schn27/Servo/doc/servo.png

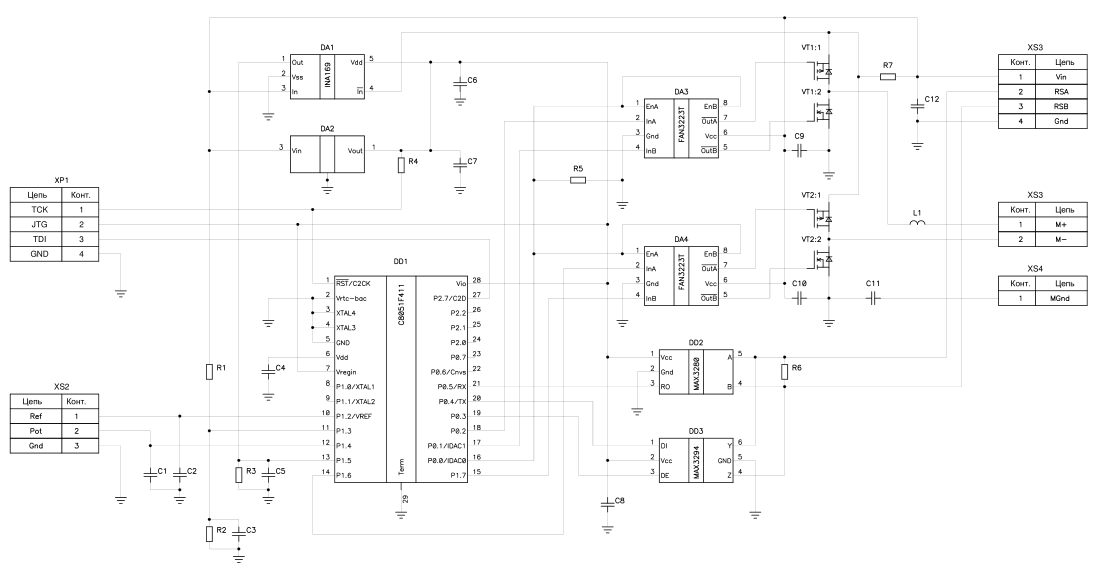
doc/servo.png
