schn27/Servo/doc/servo.xls

Title:
Author:
Count | RefDes | Value | Part Number | Description | Manufacturer
1 | C1 | 10n | 06035C103JAT2A | CAP CER 10000PF 50V X7R 5% 0603 | AVX Corporation
1 | C2 | 0.1u | 06035C104KAT2A | CAP CER .10UF 50V X7R 10% 0603 | AVX Corporation
1 | C3 | 10n | 06035C103JAT2A | CAP CER 10000PF 50V X7R 5% 0603 | AVX Corporation
1 | C4 | 4.7u | 0805YC475KAT2A | CAP CER 4.7UF 16V X7R 10% 0805 | AVX Corporation
1 | C5 | 10n | 06035C103JAT2A | CAP CER 10000PF 50V X7R 5% 0603 | AVX Corporation
1 | C6 | 0.1u | 06035C104KAT2A | CAP CER .10UF 50V X7R 10% 0603 | AVX Corporation
1 | C7 | 4.7u | 0805YC475KAT2A | CAP CER 4.7UF 16V X7R 10% 0805 | AVX Corporation
3 | C8 | 0.1u | 06035C104KAT2A | CAP CER .10UF 50V X7R 10% 0603 | AVX Corporation
 | C9 | 0.1u | 06035C104KAT2A | CAP CER .10UF 50V X7R 10% 0603 | AVX Corporation
 | C10 | 0.1u | 06035C104KAT2A | CAP CER .10UF 50V X7R 10% 0603 | AVX Corporation
1 | C11 | 22n | 0805PC223KAT1A | CAP CERM 22000PF 250V X7R 0805 | AVX Corporation
1 | C12 | 10u | GRM32DR71E106KA | CAP CER 10UF 25V 10% X7R 1210 | Murata Electronics North America
1 | DA1 |  | INA169NA/250PBF | IC CURRENT MONITOR 0.5% SOT23-5 | Texas Instruments
1 | DA2 |  | MCP1804T-3302I/MB | IC REG LDO 3.3V 150MA SOT89-3 | Microchip Technology
2 | DA3 |  | FAN3223TMPX | IC GATE DVR LOW DUAL 4A HS 8MLP | Fairchild Semiconductor
 | DA4 |  | FAN3223TMPX | IC GATE DVR LOW DUAL 4A HS 8MLP | Fairchild Semiconductor
1 | DD1 |  | C8051F411-GM | IC 8051 MCU 32K FLASH 28QFN | Silicon Laboratories Inc
1 | DD2 |  | MAX3280EAUK+T | IC RX RS485/422 SOT23-5 | Maxim Integrated Products
1 | DD3 |  | MAX3294AUT+T | IC TX RS485/422 2.5MBPS SOT23-6 | Maxim Integrated Products
1 | L1 | 22uH | 7447798221 | INDUCTOR POWER 22UH 4.1A SMD | Wurth Electronics Inc
1 | R1 | 10k | ERJ3EKF1002V | RES 10.0K OHM 1/10W 1% 0603 SMD | Panasonic - ECG
1 | R2 | 1k | ERJ3EKF1001V | RES 1.00K OHM 1/10W 1% 0603 SMD | Panasonic - ECG
1 | R3 | 10k | ERJ3EKF1002V | RES 10.0K OHM 1/10W 1% 0603 SMD | Panasonic - ECG
3 | R4 | 1k | ERJ3EKF1001V | RES 1.00K OHM 1/10W 1% 0603 SMD | Panasonic - ECG
 | R5 | 1k | ERJ3EKF1001V | RES 1.00K OHM 1/10W 1% 0603 SMD | Panasonic - ECG
 | R6 | 1k | ERJ3EKF1001V | RES 1.00K OHM 1/10W 1% 0603 SMD | Panasonic - ECG
1 | R7 | 0.056 | RL1220T-R056-G | RES .056 OHM 1/4W 2% 0805 SMD | Susumu Co Ltd
2 | VT1 |  | FDS8858CZ | MOSFET DUAL N/P-CHAN 30V SO-8 | Fairchild Semiconductor
 | VT2 |  | FDS8858CZ | MOSFET DUAL N/P-CHAN 30V SO-8 | Fairchild Semiconductor
1 | XP1 | JTG | M22-5320405 | 2.00mm Pitch DIL Vertical Pin Header SMT | Harwin Plc.
Внешний разъем
1 | XP1 |  | S10L0C-P04PFG0-200S | male crimp, 04 Contacts | ODU Steckverbindungssysteme GmbH & Co. KG
1 | XS1 |  | K10L0C-P04NFG0-200S | male crimp, 04 Contacts | ODU Steckverbindungssysteme GmbH & Co. KG
