schn27/Servo/src/F410_FlashPrimitives.c

//-----------------------------------------------------------------------------
// F410_FlashPrimitives.c
//-----------------------------------------------------------------------------
// Copyright 2006 Silicon Laboratories, Inc.
// http://www.silabs.com
//
// Program Description:
//
// This program contains several useful utilities for writing and updating
// FLASH memory.
//
// FID:            41X000050
// Target:         C8051F410/1/2/3
// Tool chain:     Keil C51 8.00
// Command Line:   None
//
//
// Release 1.0
//    -Initial Revision (GP)
//    -29 SEP 2006
//

//-----------------------------------------------------------------------------
// Includes
//-----------------------------------------------------------------------------

#include <c8051F410.h>
#include "F410_FlashPrimitives.h"

//-----------------------------------------------------------------------------
// Function Prototypes
//-----------------------------------------------------------------------------

void          flash_byteWrite (FLADDR addr, char byte);
unsigned char flash_byteRead  (FLADDR addr);
void          flash_pageErase (FLADDR addr);

//-----------------------------------------------------------------------------
// FLASH_ByteWrite
//-----------------------------------------------------------------------------
//
// Return Value : None
// Parameters   :
//   1) FLADDR addr - address of the byte to write to
//                    valid range is from 0x0000 to 0x7DFE for 32K devices
//                    valid range is from 0x0000 to 0x3FFE for 16K devices
//   2) char byte - byte to write to Flash.
//
// This routine writes <byte> to the linear FLASH address <addr>.
//-----------------------------------------------------------------------------

void flash_byteWrite (FLADDR addr, char byte) {
   bit EA_SAVE = EA;                   // Preserve EA
   char xdata * data pwrite;           // FLASH write pointer

   EA = 0;                             // Disable interrupts

   VDM0CN = 0xA0;                      // Enable VDD monitor and high threshold

   RSTSRC = 0x02;                      // Enable VDD monitor as a reset source

   pwrite = (char xdata *) addr;

   FLKEY  = 0xA5;                      // Key Sequence 1
   FLKEY  = 0xF1;                      // Key Sequence 2
   PSCTL |= 0x01;                      // PSWE = 1 which enables writes

   VDM0CN = 0xA0;                      // Enable VDD monitor and high threshold

   RSTSRC = 0x02;                      // Enable VDD monitor as a reset source

   *pwrite = byte;                     // Write the byte

   PSCTL &= ~0x01;                     // PSWE = 0 which disable writes

   EA = EA_SAVE;                       // Restore interrupts
}

//-----------------------------------------------------------------------------
// FLASH_ByteRead
//-----------------------------------------------------------------------------
//
// Return Value :
//      unsigned char - byte read from Flash
// Parameters   :
//   1) FLADDR addr - address of the byte to read to
//                    valid range is from 0x0000 to 0x7DFE for 32K devices
//                    valid range is from 0x0000 to 0x3FFE for 16K devices
//
// This routine reads a <byte> from the linear FLASH address <addr>.
//-----------------------------------------------------------------------------

unsigned char flash_byteRead (FLADDR addr) {
   bit EA_SAVE = EA;                   // Preserve EA
   char code * data pread;             // FLASH read pointer
   unsigned char byte;

   EA = 0;                             // Disable interrupts

   pread = (char code *) addr;

   byte = *pread;                      // Read the byte

   EA = EA_SAVE;                       // Restore interrupts

   return byte;
}

//-----------------------------------------------------------------------------
// FLASH_PageErase
//-----------------------------------------------------------------------------
//
// Return Value : None
// Parameters   :
//   1) FLADDR addr - address of any byte in the page to erase
//                    valid range is from 0x0000 to 0x7BFF for 32K devices
//                    valid range is from 0x0000 to 0x3DFF for 16K devices
//
// This routine erases the FLASH page containing the linear FLASH address
// <addr>.  Note that the page of Flash containing the Lock Byte cannot be
// erased if the Lock Byte is set.
//
//-----------------------------------------------------------------------------

void flash_pageErase (FLADDR addr) {
   bit EA_SAVE = EA;                   // Preserve EA
   char xdata * data pwrite;           // FLASH write pointer

   EA = 0;                             // Disable interrupts

   VDM0CN = 0xA0;                      // Enable VDD monitor and high threshold

   RSTSRC = 0x02;                      // Enable VDD monitor as a reset source

   pwrite = (char xdata *) addr;

   FLKEY  = 0xA5;                      // Key Sequence 1
   FLKEY  = 0xF1;                      // Key Sequence 2
   PSCTL |= 0x03;                      // PSWE = 1; PSEE = 1


   VDM0CN = 0xA0;                      // Enable VDD monitor and high threshold

   RSTSRC = 0x02;                      // Enable VDD monitor as a reset source
   *pwrite = 0;                        // Initiate page erase

   PSCTL &= ~0x03;                     // PSWE = 0; PSEE = 0

   EA = EA_SAVE;                       // Restore interrupts
}

//-----------------------------------------------------------------------------
// End Of File
//-----------------------------------------------------------------------------
