schn27/Servo/src/F410_FlashPrimitives.h

//-----------------------------------------------------------------------------
// F410_FlashPrimitives.h
//-----------------------------------------------------------------------------
// Copyright 2006 Silicon Laboratories, Inc.
// http://www.silabs.com
//
// Program Description:
//
// This program contains several useful utilities for writing and updating
// FLASH memory.
//
// FID:            41X000051
// Target:         C8051F410/1/2/3
// Tool chain:     Keil C51 8.00
// Command Line:   None
//
//
// Release 1.0
//    -Initial Revision (GP)
//    -29 SEP 2006
//

//-----------------------------------------------------------------------------
// Open Header #define
//-----------------------------------------------------------------------------

#ifndef _F410_FLASHPRIMITIVES_H_
#define _F410_FLASHPRIMITIVES_H_

//-----------------------------------------------------------------------------
// Structures, Unions, Enumerations, and Type Definitions
//-----------------------------------------------------------------------------

typedef unsigned long ULONG;
typedef unsigned int  UINT;
typedef unsigned char UCHAR;
typedef UINT FLADDR;

//-----------------------------------------------------------------------------
// Global Constants
//-----------------------------------------------------------------------------

#ifndef FLASH_PAGESIZE
#define FLASH_PAGESIZE 512
#endif

#ifndef FLASH_TEMP
#define FLASH_TEMP 0x7a00L             // For 32K Flash devices
//#define FLASH_TEMP 0x3C00L           // For 16K Flash devices
#endif

#ifndef FLASH_LAST
#define FLASH_LAST 0x7c00L             // For 32K Flash devices
//#define FLASH_LAST 0x3E00L           // For 16K Flash devices
#endif

//-----------------------------------------------------------------------------
// Exported Function Prototypes
//-----------------------------------------------------------------------------

void          flash_byteWrite (FLADDR addr, char byte);
unsigned char flash_byteRead  (FLADDR addr);
void          flash_pageErase (FLADDR addr);

//-----------------------------------------------------------------------------
// Close Header #define
//-----------------------------------------------------------------------------

#endif    // _F410_FLASHPRIMITIVES_H_

//-----------------------------------------------------------------------------
// End Of File
//-----------------------------------------------------------------------------
