schn27/Servo/src/deadzone.h

#ifndef DEADZONE_H
#define DEADZONE_H

#include <stdint.h>

void deadZone_move(int16_t *center, int16_t value, uint16_t deadZone);
int16_t deadZone_getValue(int16_t center, int16_t refvalue, uint16_t deadZone);

#endif
