schn27/Servo/src/stdint.h

// this is nonstandart stdint.h, because Keil doesn't include stdint.h

#ifndef STDINT_H
#define STDINT_H

typedef signed char int8_t;
typedef unsigned char uint8_t;
typedef signed short int16_t;
typedef unsigned short uint16_t;
typedef signed long int32_t;
typedef unsigned long uint32_t;

#endif
